techdregs/DIY_ESP32_Freezer_Monitor/README.md

# DIY_Freezer_Monitor
 
DIY ESP32 PCB Series

Part 1: https://youtu.be/U1wLDvrBLVI

Part 2: https://youtu.be/l0SyRu5H_q8

Part 3: https://youtu.be/rO79X10tKIA

Part 4: https://youtu.be/QCU1oav9m0I

Part 5: https://youtu.be/EvdjFdHMEKg
