techdregs/DIY_ESP32_Freezer_Monitor/Enclosure/Enclosure-Base.step

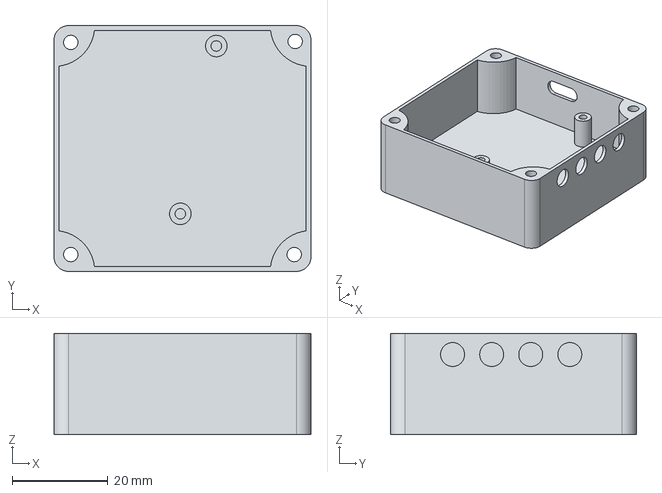
[picture p1: CAD file, 2025-10-31]
Enclosure/Enclosure-Base.step
53.6 x 51.2 x 21.1 mm
