techdregs/DIY_ESP32_Freezer_Monitor/Kicad_Project/Freezer Monitor/Resources/3D_Models/DBV0006A.stp

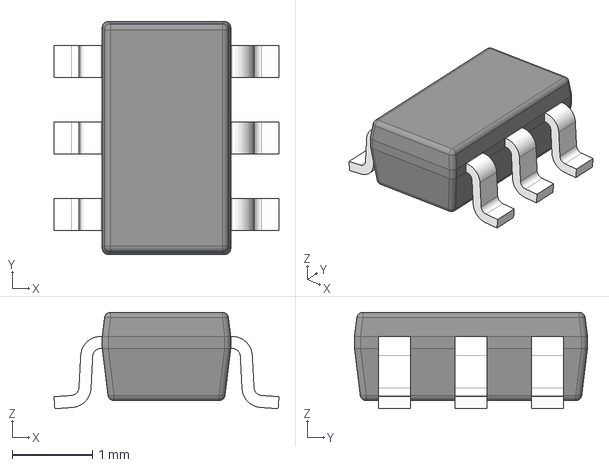
[picture p2: CAD file, 2025-10-31]
Kicad_Project/Freezer Monitor/Resources/3D_Models/DBV0006A.stp
2.80 x 2.90 x 1.20 mm
BODY-SOT
LEAD-SOT x 6
