techdregs/DIY_ESP32_Freezer_Monitor/Enclosure/Enclosure-Lid.step

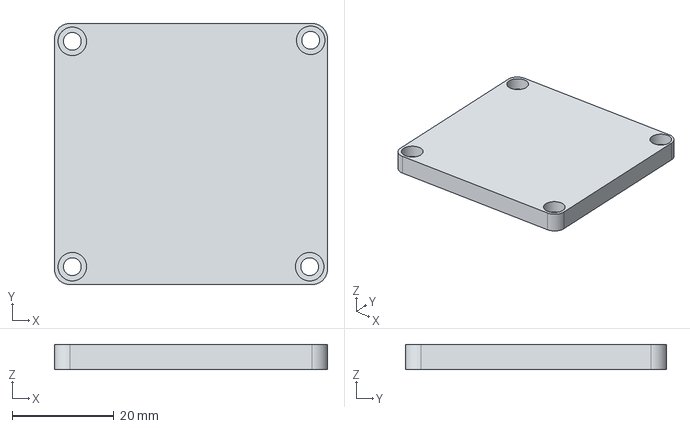
[picture p3: CAD file, 2025-10-31]
Enclosure/Enclosure-Lid.step
53.6 x 51.2 x 5.00 mm
