techdregs/DIY_ESP32_Freezer_Monitor/Kicad_Project/Freezer Monitor/Resources/3D_Models/ESD9X5.0ST5G.STEP

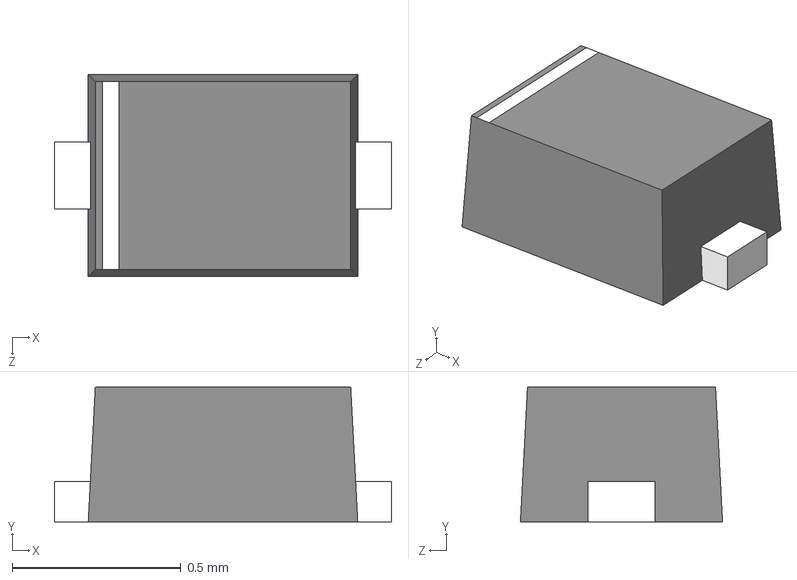
[picture p4: CAD file, 2025-10-31]
Kicad_Project/Freezer Monitor/Resources/3D_Models/ESD9X5.0ST5G.STEP
1 x 0.4 x 0.6 mm
