techdregs/DIY_ESP32_Freezer_Monitor/Kicad_Project/Freezer Monitor/Resources/3D_Models/S2B-PH-SM4-TB_LF__SN_.step

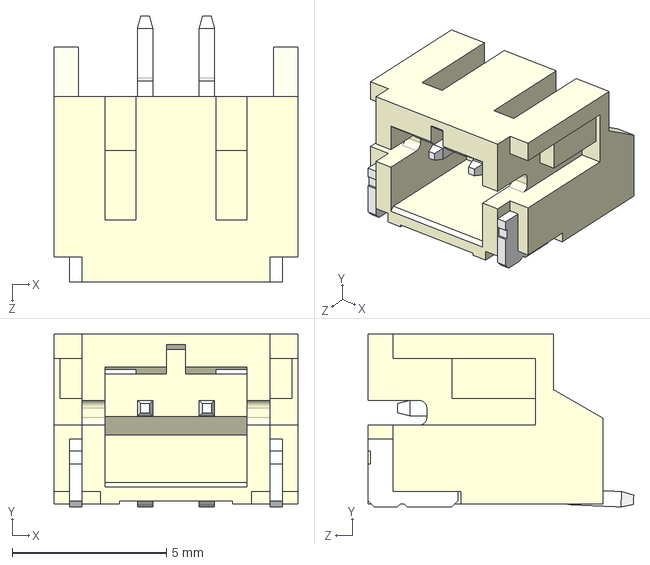
[picture p5: CAD file, 2025-10-31]
Kicad_Project/Freezer Monitor/Resources/3D_Models/S2B-PH-SM4-TB_LF__SN_.step
7.90 x 5.60 x 8.60 mm
