techdregs/DIY_ESP32_Freezer_Monitor/Kicad_Project/Freezer Monitor/Resources/3D_Models/PJ-2180-SMT.stp

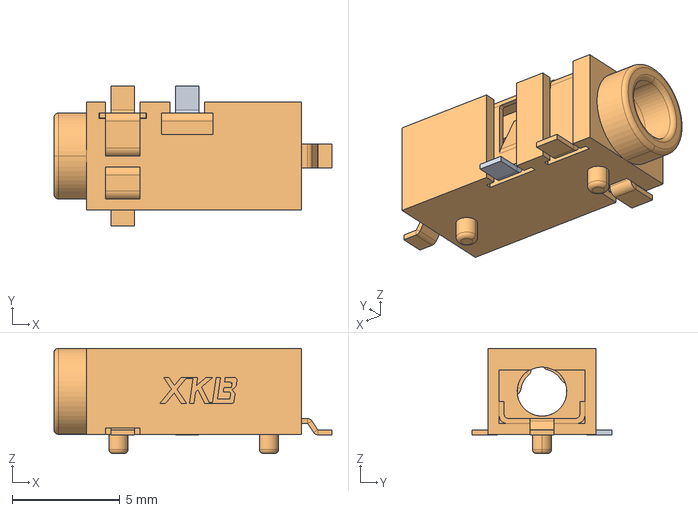
[picture p6: CAD file, 2025-10-31]
Kicad_Project/Freezer Monitor/Resources/3D_Models/PJ-2180-SMT.stp
12.9 x 6.50 x 4.90 mm
