techdregs/DIY_ESP32_Freezer_Monitor/Kicad_Project/Freezer Monitor/Resources/3D_Models/TS-1088-AR02016.step

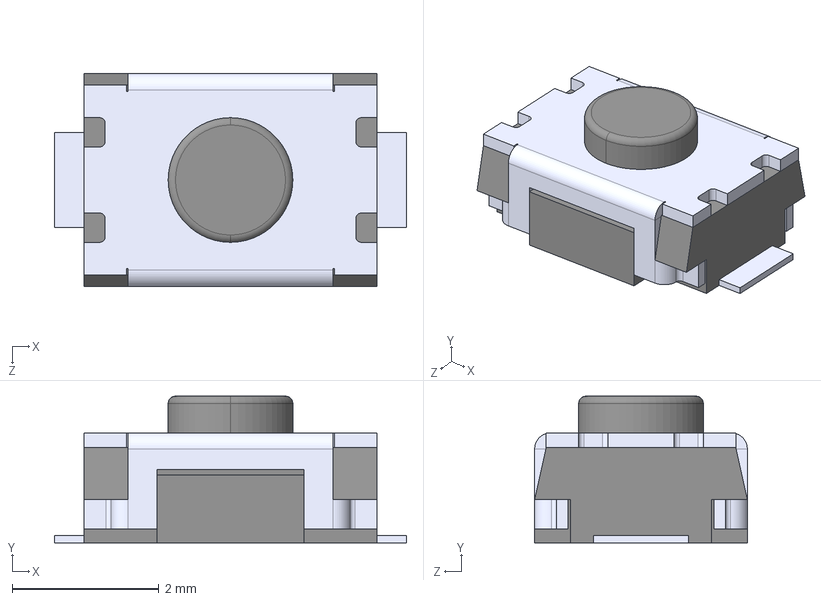
[picture p7: CAD file, 2025-10-31]
Kicad_Project/Freezer Monitor/Resources/3D_Models/TS-1088-AR02016.step
4.80 x 2.00 x 2.90 mm
