techdregs/DIY_ESP32_Freezer_Monitor/Kicad_Project/Freezer Monitor/Resources/3D_Models/ESD5B5.0ST1G.STEP

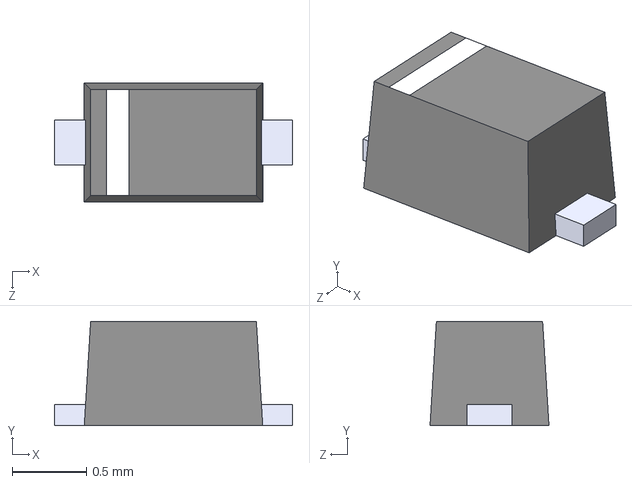
[picture p8: CAD file, 2025-10-31]
Kicad_Project/Freezer Monitor/Resources/3D_Models/ESD5B5.0ST1G.STEP
1.60 x 0.7 x 0.8 mm
