techdregs/DIY_ESP32_Freezer_Monitor/Kicad_Project/Freezer Monitor/Resources/3D_Models/DRL0006A.stp

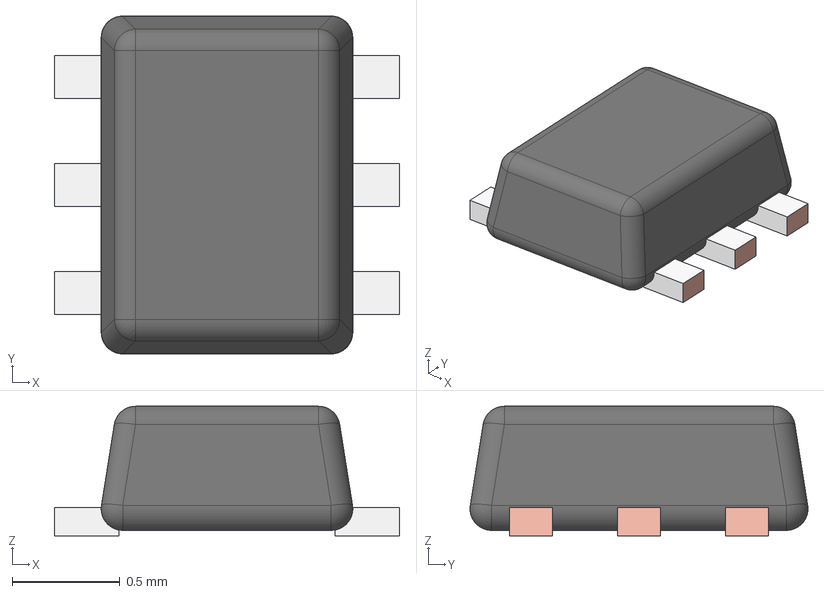
[picture p9: CAD file, 2025-10-31]
Kicad_Project/Freezer Monitor/Resources/3D_Models/DRL0006A.stp
1.60 x 1.57 x 0.6 mm
FRAME-DRL0006A
BODY-SOT
PIN1-ID
