techdregs/DIY_ESP32_Freezer_Monitor/Kicad_Project/Freezer Monitor/Resources/3D_Models/LM66200DRLR.step

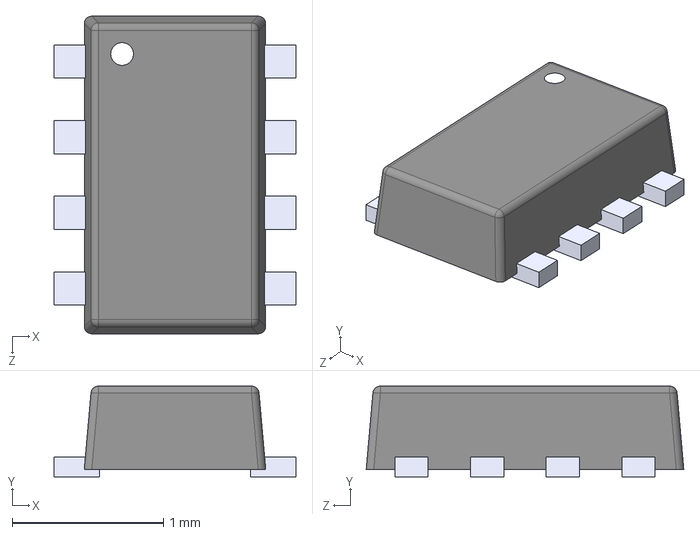
[picture p10: CAD file, 2025-10-31]
Kicad_Project/Freezer Monitor/Resources/3D_Models/LM66200DRLR.step
1.60 x 0.6 x 2.10 mm
