techdregs/DIY_ESP32_Freezer_Monitor/Kicad_Project/Freezer Monitor/Resources/3D_Models/12402012E212A--3DModel-STEP-533217.STEP

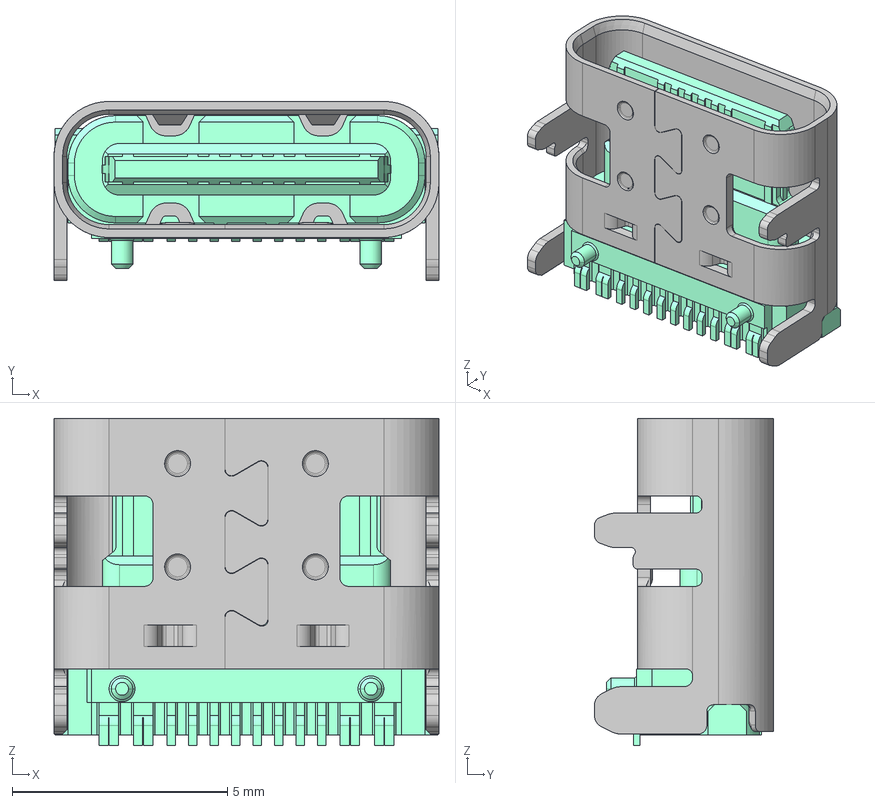
[picture p11: CAD file, 2025-10-31]
Kicad_Project/Freezer Monitor/Resources/3D_Models/12402012E212A--3DModel-STEP-533217.STEP
8.94 x 4.16 x 7.60 mm
