techdregs/DIY_ESP32_Freezer_Monitor/Kicad_Project/Freezer Monitor/Freezer Monitor.kicad_pcb

## KiCad design Kicad_Project/Freezer Monitor/Freezer Monitor.kicad_pcb (2025-10-31)

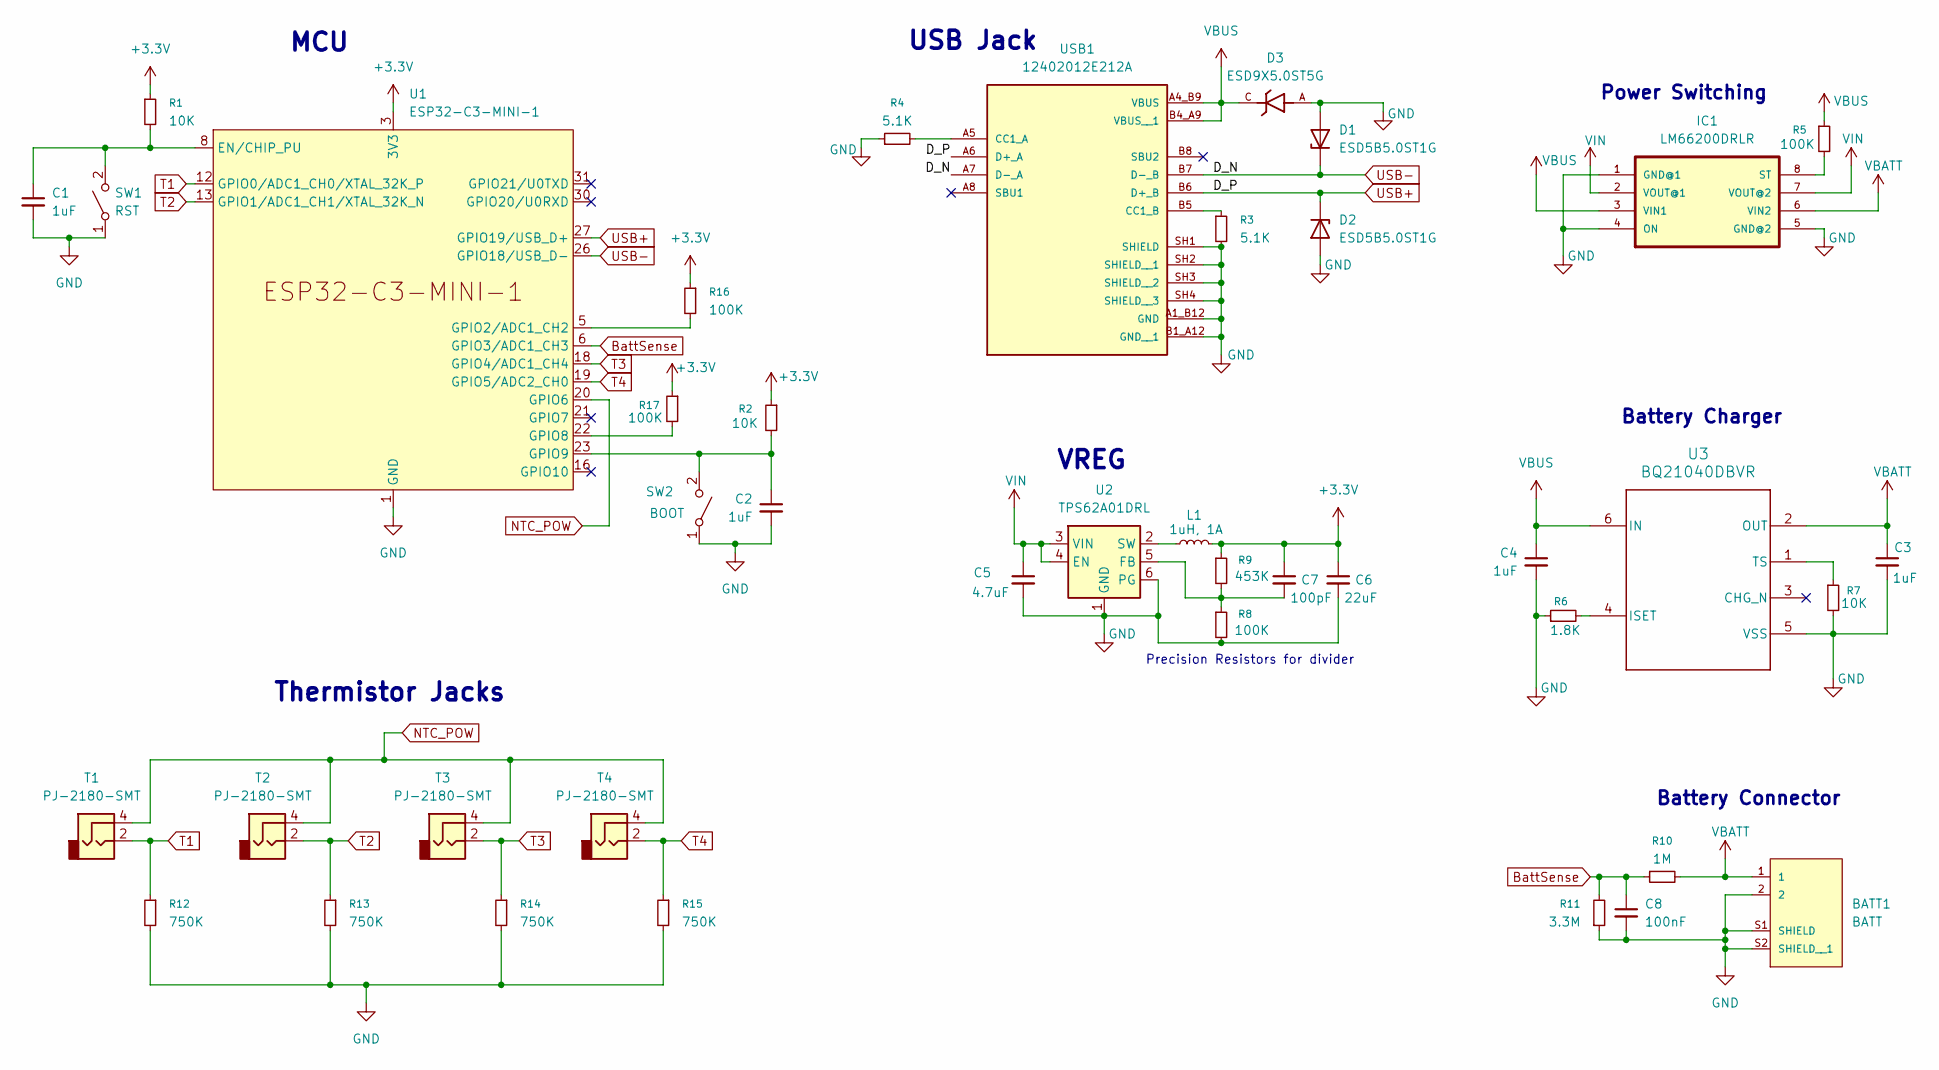
[picture p12: schematic Freezer Monitor.kicad_sch]

Parts:
BATT1: BATT; JST_S2B-PH-SM4-TB_LF__SN_
C1, C2, C3, C4: 1uF; C_0603_1608Metric
C5: 4.7uF; C_0603_1608Metric
C6: 22uF; C_0603_1608Metric
C7: 100pF; C_0603_1608Metric
C8: 100nF; C_0603_1608Metric
D1, D2: ESD5B5.0ST1G; D_SOD-523
D3: ESD9X5.0ST5G; SODFL1006X43N; PARTREV 8
IC1: LM66200DRLR; SOT8
L1: 1uH, 1A; L_1008_2520Metric
R1, R2, R7: 10K; R_0603_1608Metric
R3, R4: 5.1K; R_0603_1608Metric
R5, R8, R16, R17: 100K; R_0603_1608Metric
R6: 1.8K; R_0603_1608Metric
R9: 453K; R_0603_1608Metric
R10: 1M; R_0603_1608Metric
R11: 3.3M; R_0603_1608Metric
R12, R13, R14, R15: 750K; R_0603_1608Metric
SW1: RST; SW_TS-1088-AR02016
SW2: BOOT; SW_TS-1088-AR02016
T1, T2, T3, T4: PJ-2180-SMT; AUDIO-SMD_XKB_PJ-2180-SMT
U1: ESP32-C3-MINI-1
U2: TPS62A01DRL; SOT-563
U3: BQ21040DBVR; DBV0006A_N
USB1: 12402012E212A; AMPHENOL_12402012E212A; PARTREV 4

Connections:
+3.3V: C6.1, C7.1, L1.2, R1.1, R2.1, R9.1, R16.1, R17.1, U1.3 (3V3)
BattSense: C8.1, R10.1, R11.2, U1.6 (GPIO3/ADC1_CH3)
GND: BATT1.2, BATT1.S1 (SHIELD), BATT1.S2 (SHIELD__1), C1.2, C2.2, C3.2, C4.2, C5.2, C6.2, C8.2, D1.2 (A), D2.2 (A), D3.A, IC1.1 (GND@1), IC1.4 (ON), IC1.5 (GND@2), R3.2, R4.1, R6.1, R7.2, R8.2, R11.1, R12.2, R13.2, R14.2, R15.2, SW1.1 (A), SW2.1 (A), U1.1 (GND), U1.2 (GND), U1.11 (GND), U1.14 (GND), U1.36 (GND), U1.37 (GND), U1.38 (GND), U1.39 (GND), U1.40 (GND), U1.41 (GND), U1.42 (GND), U1.43 (GND), U1.44 (GND), U1.45 (GND), U1.46 (GND), U1.47 (GND), U1.48 (GND), U1.49 (GND), U1.50 (GND), U1.51 (GND), U1.52 (GND), U1.53 (GND), U2.1 (GND), U2.6 (PG), U3.5 (VSS), USB1.A1_B12 (GND), USB1.B1_A12 (GND__1), USB1.SH1 (SHIELD), USB1.SH2 (SHIELD__1), USB1.SH3 (SHIELD__2), USB1.SH4 (SHIELD__3)
NTC_POW: T1.4, T2.4, T3.4, T4.4, U1.20 (GPIO6)
unnamed: IC1.8 (ST), R5.2
unnamed: C1.1, R1.2, SW1.2 (B), U1.8 (EN/CHIP_PU)
unnamed: C2.1, R2.2, SW2.2 (B), U1.23 (GPIO9)
unnamed: R16.2, U1.5 (GPIO2/ADC1_CH2)
unnamed: R17.2, U1.22 (GPIO8)
unnamed: C7.2, R8.1, R9.2, U2.5 (FB)
unnamed: L1.1, U2.2 (SW)
unnamed: R6.2, U3.4 (ISET)
unnamed: R7.1, U3.1 (TS)
unnamed: R4.2, USB1.A5 (CC1_A)
unnamed: R3.1, USB1.B5 (CC1_B)
T1: R12.1, T1.2, U1.12 (GPIO0/ADC1_CH0/XTAL_32K_P)
T2: R13.1, T2.2, U1.13 (GPIO1/ADC1_CH1/XTAL_32K_N)
T3: R14.1, T3.2, U1.18 (GPIO4/ADC1_CH4)
T4: R15.1, T4.2, U1.19 (GPIO5/ADC2_CH0)
USB+: D2.1 (K), U1.27 (GPIO19/USB_D+), USB1.A6 (D+_A), USB1.B6 (D+_B)
USB-: D1.1 (K), U1.26 (GPIO18/USB_D-), USB1.A7 (D-_A), USB1.B7 (D-_B)
VBATT: BATT1.1, C3.1, IC1.6 (VIN2), R10.2, U3.2 (OUT)
VBUS: C4.1, D3.C, IC1.3 (VIN1), R5.1, U3.6 (IN), USB1.A4_B9 (VBUS), USB1.B4_A9 (VBUS__1)
VIN: C5.1, IC1.2 (VOUT@1), IC1.7 (VOUT@2), U2.3 (VIN), U2.4 (EN)

Notes on the sheet:
Thermistor Jacks
USB Jack
Battery Charger
VREG
MCU
Battery Connector
Precision Resistors for divider
Power Switching

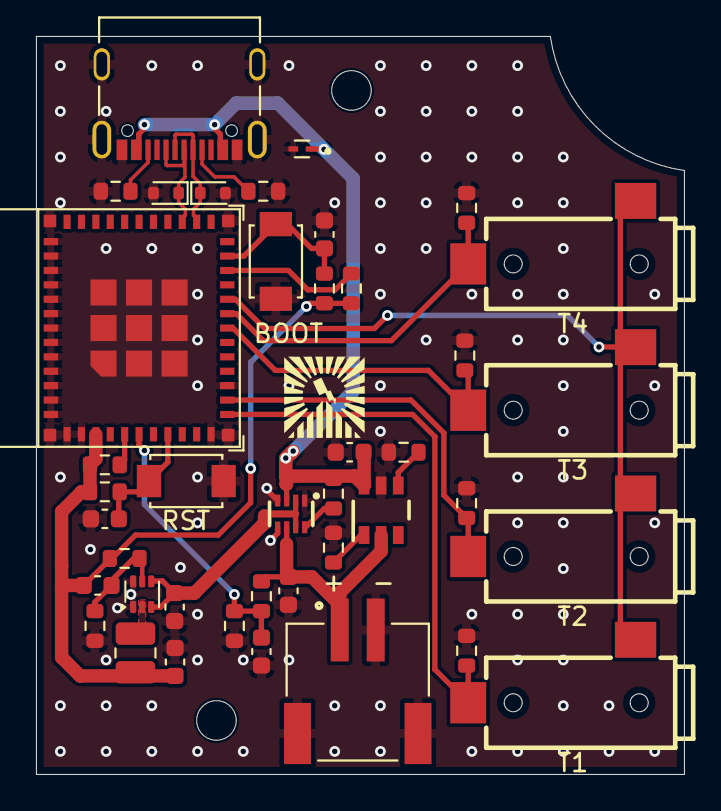
[picture p13: board Freezer Monitor.kicad_pcb from above]

Board: 2 copper layers, 36.0 x 41.0 mm, 41 parts (0 on the bottom side), 24 nets.
